resende-g/d-BMO-body/docs/hardware.md

# Hardware

O conteúdo deste arquivo foi incorporado ao [README](../README.md), que é a fonte única da documentação do projeto. Seções correspondentes:

- [Lista de componentes (BOM)](../README.md#lista-de-componentes-bom)
- [Arquitetura](../README.md#arquitetura)
- [Pinagem (ESP32-S3 N16R8)](../README.md#pinagem-esp32-s3-n16r8)
- [Alimentação](../README.md#alimentação)
- [Configurações críticas](../README.md#configurações-críticas)

Documentação técnica de hardware (fora do README):

- [Mapa de GPIOs](hardware/GPIO_MAP.md)
- [Arquitetura de barramentos](hardware/BUS_ARCHITECTURE.md)
- [Matriz de componentes](hardware/COMPONENT_MATRIX.md)
- [Arquitetura de alimentação](hardware/POWER_ARCHITECTURE.md) e [orçamento de energia](hardware/POWER_BUDGET.md)
- [Guia de montagem](hardware/ASSEMBLY_GUIDE.md)
- [Notas regulatórias de RF](hardware/RF_REGULATORY_NOTES.md)
- [Registros de evidência](hardware/sources/)
