resende-g/d-BMO-body/mechanical/cad/out/esp32_s3_wroom_1__antenna_keepout.step

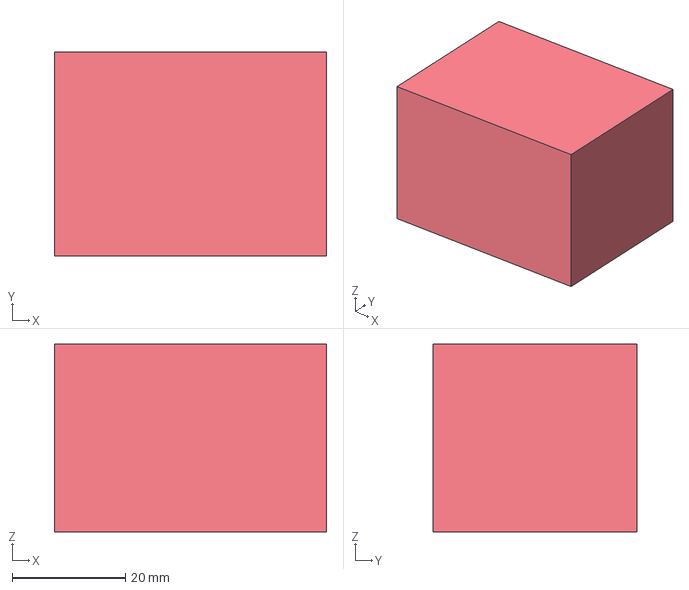
[picture p2: CAD file, 2026-11-12]
mechanical/cad/out/esp32_s3_wroom_1__antenna_keepout.step
48.0 x 36.0 x 33.1 mm
