resende-g/d-BMO-body/mechanical/cad/out/esp32_s3_wroom_1__antenna_zone.step

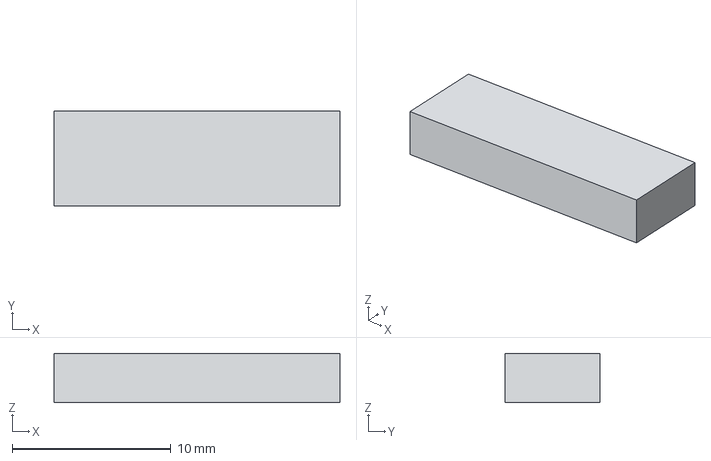
[picture p3: CAD file, 2026-11-12]
mechanical/cad/out/esp32_s3_wroom_1__antenna_zone.step
18.0 x 5.95 x 3.10 mm
