resende-g/d-BMO-body/mechanical/cad/out/esp32_s3_wroom_1__envelope.step

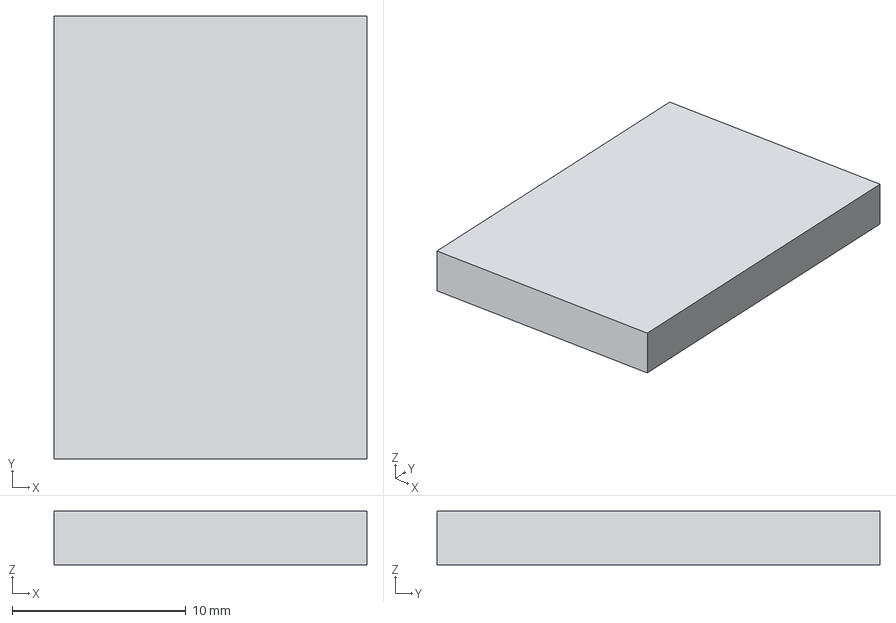
[picture p4: CAD file, 2026-11-12]
mechanical/cad/out/esp32_s3_wroom_1__envelope.step
18.0 x 25.5 x 3.10 mm
