resende-g/d-BMO-body/tests/unit/input/test_button_processor.cpp

#include "dbmo/input/button_processor.h"
#include "dbmo_test.h"

using dbmo::Status;
using namespace dbmo::input;

namespace {

struct Log {
  ButtonEvent events[96];
  int count = 0;
  uint8_t combos[32];
  int comboCount = 0;

  int countOf(Button button, ButtonAction action) const {
    int matches = 0;
    for (int i = 0; i < count; ++i)
      if (events[i].button == button && events[i].action == action) ++matches;
    return matches;
  }
};

void onButton(const ButtonEvent &event, void *context) {
  auto *log = static_cast<Log *>(context);
  if (log->count < 96) log->events[log->count++] = event;
}

void onCombo(uint8_t id, void *context) {
  auto *log = static_cast<Log *>(context);
  if (log->comboCount < 32) log->combos[log->comboCount++] = id;
}

struct Fixture {
  ButtonProcessor processor;
  Log log;
  uint32_t now = 0;

  Fixture() { processor.setSinks(onButton, onCombo, &log); }
  // Mantém a leitura bruta por durationMs, chamando update a cada milissegundo.
  void hold(ButtonMask raw, uint32_t durationMs) {
    for (uint32_t i = 0; i < durationMs; ++i) processor.update(raw, ++now);
  }
};

constexpr ButtonMask kA = maskOf(Button::A);
constexpr ButtonMask kB = maskOf(Button::B);
constexpr ButtonMask kUp = maskOf(Button::DpadUp);
constexpr ButtonMask kSelect = maskOf(Button::Select);

}  // namespace

void setUp() {}
void tearDown() {}

static void test_bounce_shorter_than_the_debounce_time_is_ignored() {
  Fixture f;
  // Repique: a leitura alterna a cada 5 ms durante 60 ms (o tempo estável exigido é 20).
  for (int i = 0; i < 12; ++i) f.hold((i % 2 == 0) ? kA : 0, 5);
  TEST_ASSERT_EQUAL_INT(0, f.log.count);

  f.hold(kA, 19);
  TEST_ASSERT_EQUAL_INT(0, f.log.count);  // ainda não completou 20 ms estável
  f.hold(kA, 2);
  TEST_ASSERT_EQUAL_INT(1, f.log.count);
  TEST_ASSERT_TRUE(f.log.events[0].action == ButtonAction::Pressed);
  TEST_ASSERT_TRUE(f.processor.isPressed(Button::A));
}

static void test_short_press_is_a_click() {
  Fixture f;
  f.hold(kA, 100);
  f.hold(0, 50);
  TEST_ASSERT_EQUAL_INT(3, f.log.count);
  TEST_ASSERT_TRUE(f.log.events[0].action == ButtonAction::Pressed);
  TEST_ASSERT_TRUE(f.log.events[1].action == ButtonAction::Released);
  TEST_ASSERT_TRUE(f.log.events[2].action == ButtonAction::Click);
  TEST_ASSERT_FALSE(f.processor.isPressed(Button::A));
}

static void test_long_press_fires_once_and_cancels_the_click() {
  Fixture f;
  f.hold(kA, 20 + 599);  // 20 ms de debounce + 599 ms segurado
  TEST_ASSERT_EQUAL_INT(0, f.log.countOf(Button::A, ButtonAction::LongPress));
  f.hold(kA, 2);
  TEST_ASSERT_EQUAL_INT(1, f.log.countOf(Button::A, ButtonAction::LongPress));
  f.hold(kA, 3000);
  TEST_ASSERT_EQUAL_INT(1, f.log.countOf(Button::A, ButtonAction::LongPress));
  f.hold(0, 50);
  TEST_ASSERT_EQUAL_INT(1, f.log.countOf(Button::A, ButtonAction::Released));
  TEST_ASSERT_EQUAL_INT(0, f.log.countOf(Button::A, ButtonAction::Click));
}
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
