resende-g/d-BMO-body/(commit log)

2026-11-12 feat(core): add firmware core, canonical pin map and native test infrastructure
    Foundation of the d-BMO own firmware, portable C++17 with no Arduino dependency:
    - firmware/core: Status/Result error model, HAL contracts (clock, GPIO, SPI, I2C,
    ADC, PWM, critical section), logger with sinks and RAM history, asynchronous
    EventBus, table-driven state machine, System (ordered subsystem boot, health
    state, fault history, retry), typed ConfigStore with text persistence, and a
    ResourceRegistry that detects pin/address conflicts at run time.
    - firmware/config: canonical pin map with two profiles (target = proposed v1
    pinout, bench = today's breadboard), bus addresses and compile-time check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
    [config_store.cpp, crc.cpp]
2026-11-12 feat: add bench console, integrity tools and MCP23017 pin-map correction
    - firmware/app: portable serial console (line editor, argument splitting with
    quotes, command table) with unit tests.
    - tools: check_pinmap.py (pins.h against the Bruce flags, the Retro-Go target
    and generated Markdown blocks), check_links.py (relative links and anchors)
    and check_repo.py (structure, portability rules, no network stack, no
    secrets, shell syntax).
    - pins.h: the Microchip MCP23017 datasheet (DS20001952 rev. D) declares GPA7
    and GPB7 output-only, so no button is mapped to bits 7 and 15. One expander
    offers 14 inputs; the two stick clicks are proposed on the second expander
    and remain an open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
    [check_links.py, check_pinmap.py, check_repo.py, console.cpp]
2026-11-12 feat(platform): add ESP32-S3 port skeleton, PlatformIO project and CI
    - firmware/platform/esp32s3: Arduino-ESP32 (core 3.x) implementations of the
    core HAL contracts (clock, GPIO, SPI device on the shared bus, I2C bus, ADC,
    LEDC PWM, critical section, serial log sink, NVS config backend) and an
    IDisplay adapter over Adafruit_ILI9341. Written against the 3.3.9 headers;
    not compiled locally (the PlatformIO registry is unreachable from the
    development sandbox), so the first compile happens in CI.
    - platformio.ini: environments dbmo-bench and dbmo-target on the same pinned
    platform as Bruce 1.16.1 (pioarduino 55.03.39), board esp32-s3-devkitc1-n16r8.
    - firmware/app/src/main.cpp: entr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
2026-11-12 ci: use PlatformIO Core 6.1.19, required by the pinned ESP32 platform
    The first CI run failed before compiling: pioarduino 55.03.39 declares
    "platformio >= 6.1.19" and the job installed 6.1.18. Also adds the testing
    guide (docs/testing/TESTING.md).
    Claude-Session: https://claude.ai/code/session_01WrzgMNVrX3VuxPSqDqFbCV
2026-11-12 test(hardware): add display and I2C scan bench tests; add display manifest
    PlatformIO refuses a symlink:// dependency without a manifest, which stopped
    the second CI run before compiling. Adds firmware/display/library.json and
    the first two on-device tests (ILI9341 identification through the port, I2C
    idle levels and address scan). The bench tests are only compiled in CI.
    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
2026-11-12 docs(hardware): add evidence registers and RF regulatory note
    - docs/hardware/sources/ESP32-S3.md and PERIPHERALS.md: evidence registers
    (claim, value, source, location, status) for the SoC, module, DevKitC and
    every peripheral, with the list of points that could not be verified and the
    divergences found against the README. Manufacturer hosts were unreachable
    from the sandbox, so datasheets were read from identified third-party copies
    and Espressif sources from public repositories; this is stated in each file.
    - docs/hardware/RF_REGULATORY_NOTES.md: engineering note on the Brazilian
    rules for the radios. No normative source could be opened in the session, so
    every normative poi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
2026-11-12 docs(mechanical): add mechanical specification, dimension register and parametric CAD
    - docs/mechanical: MECHANICAL_SPECIFICATION, COMPONENT_DIMENSIONS (each
    dimension classified as confirmed by the manufacturer, nominal or pending
    measurement) and ASSEMBLY_LAYOUT (zones, stacking, keep-outs, named
    parameters to fill after measuring).
    - mechanical/cad: components.yaml (machine-readable register), a CadQuery
    generator that refuses to model any component with a non-confirmed
    dimension, its self-test (22 checks pass locally) and the STEP envelopes of
    the only component fully confirmed so far, the ESP32-S3-WROOM-1 module.
    Licensed under CERN-OHL-P-2.0.
    The independent review pass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
    [esp32_s3_wroom_1__antenna_keepout.step, esp32_s3_wroom_1__antenna_zone.step, esp32_s3_wroom_1__envelope.step]
2026-11-12 feat(bruce): implement power functions, MCP23017 input path and harden the build
    - interface.cpp: deep sleep with wake on the OK button (goToDeepSleep,
    powerOff); getBattery/isCharging/power-latch behind DBMO_* flags that are
    off by default, so no sensor value is fabricated while the hardware does not
    exist; optional MCP23017 input path (env bmo-v1-mcp) that leaves GPA7/GPB7
    as outputs, as the Microchip datasheet requires.
    - bmo.ini: stale comments fixed, TOUCH_CS defined, device renamed to d-BMO v1,
    and the three signal jammers of Bruce (RF, IR, NRF24) excluded from the
    d-BMO build; disabled_features.cpp shows a notice in their place.
    - build.sh: usable in CI (PIO lookup, pinned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
    [disabled_features.cpp, interface.cpp]
2026-11-12 feat(retro-go): add dbmo-v1 build target for Retro-Go
    Target files (config.h, env.py, sdkconfig) derived from the upstream
    esp32-s3-devkit and fri3d-2024 targets at commit 4ced120, a build script that
    clones the pinned upstream, registers the target and calls rg_tool.py, a host
    syntax check against IDF stubs (passes locally) and the integration README.
    GPL-2.0, as upstream.
    The button map follows pins.h: 14 buttons on the MCP23017, none on GPA7/GPB7.
    The firmware was never compiled with ESP-IDF nor run on the device; the
    independent review pass did not run (usage limit).
    Claude-Session: https://claude.ai/code/session_01WrzgMNVrX3VuxP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
2026-11-12 fix(rosto): keep the hand-drawn layout of the face table
    The previous commit ran clang-format over rosto_faces.h and collapsed each
    frame into run-on lines, which defeats the purpose of drawing the faces as
    text. Restores the one-row-per-line layout for all 17 expressions (content
    unchanged: the CRC-32 golden test of the ten specification faces still
    passes) and excludes the sketch files from tools/check_format.sh.
    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
    [rosto_faces.h]
2026-11-12 feat(input): add controls subsystem with MCP23017 driver and simulator
    - Logical model of the 16 buttons and two sticks, independent of the wiring.
    - IButtonSource with two backends: Mcp23017ButtonSource (expander at 0x20) and
    GpioButtonSource (the three bench buttons). The MCP23017 driver refuses to
    configure GPA7/GPB7 as inputs, as datasheet revision D requires.
    - ButtonProcessor: debounce, click, long press, auto-repeat and combos (with
    optional hold time and repeat) that suppress their member buttons.
    - StickProcessor: centre and range calibration with sanity limits, radial
    rescaled dead zone, normalisation to +-1000, ADC error handling.
    - InputSubsystem: fixed-period polling, ev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
    [button_processor.cpp, button_processor.h, button_source.h, button_sources.cpp, input_subsystem.cpp, input_subsystem.h, mcp23017.cpp, mcp23017.h]
2026-11-12 feat(cartridges): add cartridge system and its technical specification
    - docs/cartridges/CARTRIDGE_SPECIFICATION.md: scope, connector signals, a
    PROPOSED (not final) contact assignment designed so that a reversed
    cartridge never ties one supply rail to another, evaluation of the 24C02
    against alternatives, byte-level header format, versioning and
    compatibility rules, life cycle, hot-plug risks, security and open items.
    - Eeprom24c02 driver: 8-byte pages (safe across manufacturers), acknowledge
    polling for the write cycle, read-back verification.
    - Identification header (64 bytes, CRC-16) with exhaustive validation that
    tells blank, corrupted, unsupported and out-of-range data apa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
    [cartridge_driver.h, cartridge_header.cpp, cartridge_header.h, cartridge_image.cpp, cartridge_subsystem.cpp, cartridge_subsystem.h, eeprom_24c02.cpp]
2026-11-12 feat(power): add battery monitor, power button, latch and orderly shutdown
    - BatteryMonitor: ADC + divider, 8-sample average, levels with hysteresis.
    Reading is disabled by default (the divider does not exist yet) and a
    sample is only accepted when the ADC answered, the pin voltage is inside
    the calibrated ADC range and the result is plausible for a 1S cell;
    otherwise the level is Unknown. No percentage estimate, no invented values.
    - Hardware contracts (IChargerStatus, IPowerSwitch, ISleepControl) with
    GPIO-only implementations; every part is optional.
    - PowerSubsystem: holds the power latch first, debounced power button that
    ignores the press that turned the device on, long pre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
2026-11-12 feat(radio): add CC1101 driver with receive and policy-gated transmit
    - Parametric configuration: frequency, data rate, filter bandwidth and
    deviation are converted to the chip fields with the datasheet formulas and
    validated against the chip bands.
    - Cc1101 driver in packet (FIFO) mode over ISpiDevice: reset, identification
    that tells a real chip from a floating bus, configuration verified by
    read-back, polled receive with CRC/overflow/malformed handling, polled
    transmit, sleep.
    - Transmit policy: disabled by default, no band assumed, the user must
    enable it and state the band; the occupied bandwidth must fit the band
    and an airtime budget (600 ms per minute by default) preven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
    [cc1101.cpp, cc1101_sim.h, radio_config.cpp, radio_config.h, radio_subsystem.cpp]
2026-11-12 feat(nfc): add PN532 driver limited to chip and tag identification
    - Frame codec with length-complement and checksum validation.
    - Non-blocking Pn532 driver over I2C: command, ACK and response are tracked
    by polling with deadlines; a command with no answer is aborted.
    - NfcSubsystem: identifies the chip at boot (bounded wait), scans
    periodically when asked, reports a tag once on arrival and after two empty
    scans on removal, recovers from chip faults.
    - Scope is identification only: the chip only ever receives
    GetFirmwareVersion, SAMConfiguration, RFConfiguration and
    InListPassiveTarget (asserted by a test). No authentication, memory
    read/write, data exchange, card emulation or cr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
2026-11-12 feat(infrared): add receive, protocol identification, code library, gated send
    - NEC and Sony SIRC (12/15/20 bits) encode and decode with tolerance for
    receiver distortion; anything else is kept as a raw signal.
    - InfraredSubsystem: received codes and repeats as events, learning mode
    that captures the next signal, own transmission ignored on receive.
    - Code library: one-line text format (nec/sony/raw) with strict parsing and
    validated names, stored through an interface the application implements.
    - Send is disabled by default and limited by an emission budget per minute,
    a maximum duration per send and a 30-60 kHz carrier range. No continuous
    emission, no automatic power-code sweep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
    [infrared_subsystem.h, ir_codec.h, ir_library.h, ir_types.h]
2026-11-12 feat(audio): add I2S contracts, volume, tone generator, playback and recording
    - IAudioOutput / IAudioInput contracts (non-blocking), IAudioSource,
    BufferSource and a volume control with a quadratic curve that never
    amplifies.
    - ToneSource: integer tone generator with fade-in and fade-out.
    - AudioSubsystem: bounded work per tick, no sample lost when the I2S queue
    is full, amplifier off at rest and after playback, fault handling.
    - Only sample rates valid for both the MAX98357A and the INMP441 are
    accepted (8, 16, 32, 44.1, 48 kHz); an invalid setting falls back to
    16 kHz with a warning.
    - Privacy: microphone disabled by default, recording always announced by
    an event before the f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
2026-11-12 feat(app): add the portable Application composition root and integration tests
    - Application wires the ten subsystems through interfaces only, so the same
    class runs on the ESP32-S3 and in the tests. Missing hardware is replaced
    by "absent" HAL objects: the subsystem reports HardwareAbsent and the
    system carries on in Degraded, with no special cases.
    - Boot order: power (holds the latch), storage, config, display and face
    (required), then the optional peripherals.
    - ConfigPersistence: configuration on the card when there is one, internal
    storage otherwise; changes are grouped and saved after 2 s; a corrupt file
    does not stop the boot.
    - Face reactions to events (tag, packet, IR c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
    [app_commands.cpp, application.cpp, test_application.cpp]
2026-11-12 feat(platform): ESP32-S3 adapters and main.cpp built on Application
    - peripherals.h: SdFileSystem (SD library), I2sAudio (amplifier and
    microphone on one clock pair, 32-bit stereo frames, non-blocking writes,
    reception enabled only while recording), RmtIrReceiver / RmtIrTransmitter
    (1 us ticks, carrier per send) and DeepSleepControl (wake on an RTC pin).
    - main.cpp now only creates the port objects and tells Application which
    hardware exists, with two profiles: today's breadboard (display, three
    GPIO buttons, IR) and the proposed v1 pinout. The card is mounted first
    on the shared SPI bus.
    - platformio.ini: all subsystem libraries added.
    None of the adapters has run on hardware;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
2026-11-12 docs(hardware): GPIO map, bus architecture, component matrix, power, assembly
    Six hardware documents written from the evidence registers, each claim tied
    to an evidence id and classified as confirmed by the manufacturer, proposed
    or pending physical validation:
    - GPIO_MAP: pin tables generated from pins.h, ESP32-S3 restrictions, ten
    open risks per pin (GPIO0 as power button, UART0 for the cartridge,
    non-RTC latch pin...) and the bench tests that close them.
    - BUS_ARCHITECTURE: shared SPI and I2C rules, I2S full duplex, UART, RMT,
    ADC, known conflicts.
    - COMPONENT_MATRIX: function, interface, supply, purchase and validation
    state, logic-level caveats and risks per component.
    - POWER_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
2026-11-12 ci: build Bruce and Retro-Go for the d-BMO and run the CAD self-test
    Neither the Bruce board nor the Retro-Go target had ever been compiled.
    Three new jobs make that visible on every pull request:
    - bruce: builds the pinned Bruce release with the d-BMO board, for the
    bmo-v1 and bmo-v1-mcp environments.
    - retro-go-host-check and retro-go: syntax check of the target on the host
    and a launcher build in the espressif/idf:v4.4.8 container.
    - cad: self-test of the parametric model generator with the recorded
    cadquery versions.
    None of them uses continue-on-error: a failure is reported, not hidden.
    Claude-Session: https://claude.ai/c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
2026-11-12 docs: architecture and firmware guides; README corrections
    - docs/architecture/ARCHITECTURE.md: layers and dependency rules, core,
    global state, fault handling, boot order, reactions between modules,
    shutdown, execution model, testability, how to add a subsystem.
    - docs/firmware/FIRMWARE.md: module table, build and flash, console
    commands, every configuration key with default and range, events, the
    usage limits built into the firmware and what does not exist yet.
    - README: status of the own firmware and an index of the technical docs.
    Corrections backed by the evidence registers: the MCP23017 has 14 usable
    inputs, not 16; ADC2 wording; open risks of GPIO0 as power button and of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
2026-11-12 fix(bruce,retro-go): apply datasheet findings; add bench tests and port docs
    - Bruce: goToDeepSleep() no longer waits forever for the wake button to be
    released; with a stuck button it gives up after 10 s instead of hanging.
    SPI_READ_FREQUENCY lowered to 6 MHz, inside the ILI9341 read limit
    (150 ns cycle); comments no longer suggest 40 MHz without noting that the
    datasheet write limit is 10 MHz.
    - Retro-Go target: the 40 MHz display clock outside the bench profile is
    documented as outside the datasheet limit and pending validation.
    - Bench tests (compile only in CI): test_cc1101 (identify, read-back,
    receive state, RSSI; never transmits), test_pn532 (address, firmware
    version,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
    [config.h, interface.cpp, test_main.cpp]
2026-11-12 fix(radio,nfc): make the usage restrictions structural, not conventional
    Adversarial review of the low-level entry points found two ways around the
    limits that the higher layers enforce:
    - Cc1101::writeRegister() was public and unrestricted, so code holding the
    driver could change the frequency, the data rate or the packet mode
    (including the chip's random-data and asynchronous modes in PKTCTRL0, or
    "stay in TX" in MCSM1) after the transmit policy had approved a different
    configuration. The registers that define what goes on air are now written
    only by configure(); writeRegister() and applyOverrides() refuse them.
    - Pn532::start() accepted any command code, so authentication, data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
    [cc1101.cpp]
2026-11-12 docs(testing): record measured line coverage
    Line coverage of the portable firmware measured with gcov over all test
    binaries: 4343 of 4544 executable lines (95.6 %), per module, with the
    least covered files named. main.cpp and the ESP32-S3 port are outside the
    measurement because they do not build on the host.
    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
2026-11-12 docs: record the first fully green CI run and retire stale "never compiled" notes
    CI run 20 (commit 79cee67) passed all nine jobs. It is the first time the
    Bruce board (bmo-v1 and bmo-v1-mcp) and the Retro-Go target (launcher,
    ESP-IDF 4.4.8) were compiled for the d-BMO.
    - TESTING.md: per-job evidence and what each job proves; the list of what
    was not executed now says "compiled in CI, never flashed" for Bruce and
    Retro-Go, and names the Retro-Go emulators as still not compiled.
    - Bruce README: the two environments compile in CI; the code behind the
    DBMO_VBAT_ADC_PIN, DBMO_CHG_STAT_PIN and DBMO_POWER_HOLD_PIN flags is
    still not compiled because the flags are off in both environments.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
2026-11-12 fix: address the findings of the independent adversarial review
    Radio: channel, frequency-offset and channel-spacing registers are now
    policy registers and are reset by configure(); a failed reconfiguration
    leaves the driver unconfigured and sends the subsystem to Fault instead of
    transmitting with mixed registers; transmit grants are single-use and bound
    to frequency, occupied bandwidth and airtime; crystal and power changes are
    written to the chip; the airtime window can no longer admit twice the
    budget within 60 s; the power table is rewritten before each transmission.
    Infrared: sliding emission budget; extended NEC addresses with a zero high
    byte keep their identity (necx: in the text f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
    [application.cpp, cartridge_header.cpp, cartridge_subsystem.cpp, cartridge_subsystem.h, cc1101.cpp]
2026-11-12 docs(cartridges): specify protective plastic cartridge housing
2026-11-12 docs(mechanical): specify guided cartridge housing and dock
2026-11-12 docs(mechanical): clarify cartridge insertion depth and protrusion
2026-11-12 docs(cad): mark previous cartridge protrusion as obsolete
2026-11-12 docs(cad): sync generated cartridge parameter register
2026-11-14 docs: drop the discontinued ESP32-P4 and other stale history
    The ESP32-P4 + C6 variant is discontinued. Remove docs/dbbs-1.0.md (its
    battery spec targeted the P4 with a 5 V/3 A boost) and keep only its
    cell acceptance criteria, now in the README battery risks.
    Replace "boost 5V" with the 3.3 V regulator the S3 actually needs, which
    resolves the power inconsistency note. Remove history that no longer
    matches the project: the P4 cart, struck-out BOM rows, dated
    correction/update notes, the old ~40 mm cartridge protrusion estimate
    (also dropped from the CAD register), and "to do" items that are done
    (Retro-Go dbmo-v1 target, MCP23017 input in Bruce, 17-expression face).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
    [components.yaml]
